Orion-Black/Orion-IoT_Board/docs/Schematic_IoT_Orion.pdf

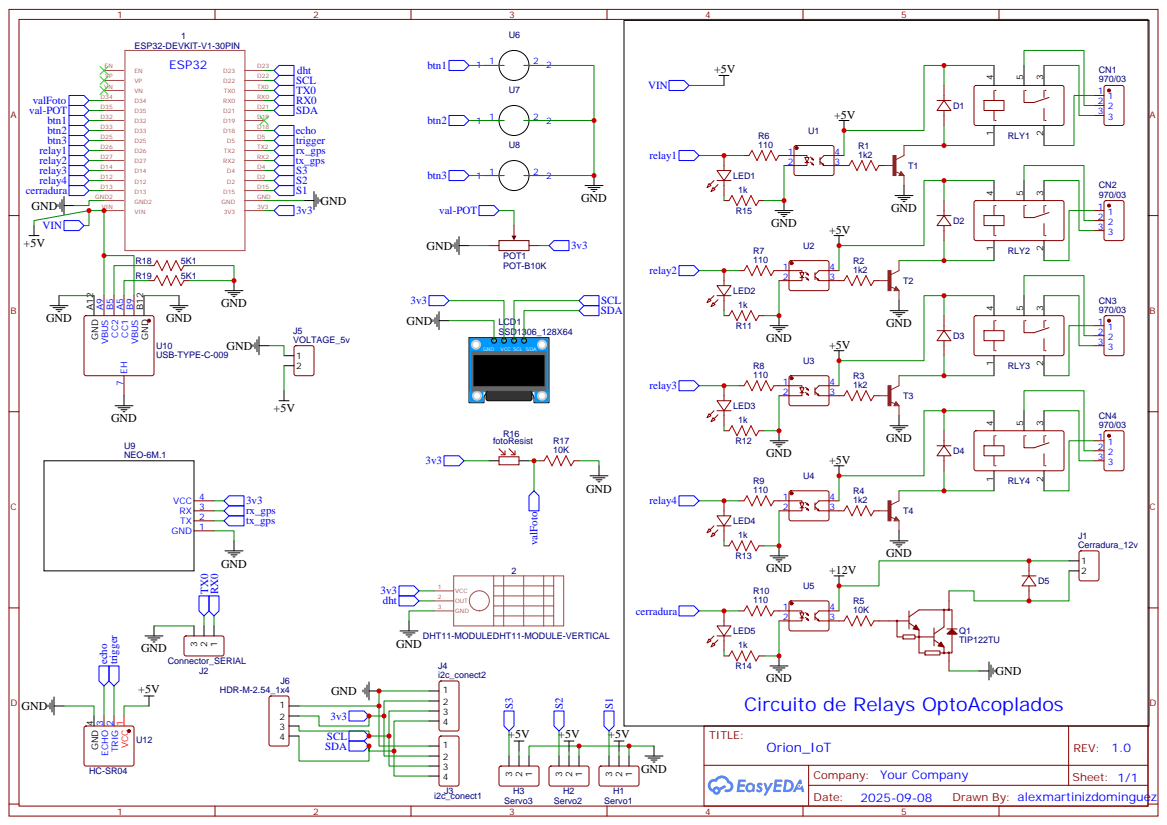
[picture p10: page 1]

GND VCC SCL SDA
