Orion-Black/Orion-IoT_Board/src/wifi_defaults.h

#ifndef WIFI_DEFAULTS_H
#define WIFI_DEFAULTS_H

#define DEFAULT_SSID "Starlink 2.4"
#define DEFAULT_PASS "L3tr4s_123"

#endif
