Orion-Black/Orion-IoT_Board/src/icons.h

// Logo principal Orion IoT
const unsigned char init_icon [] PROGMEM = {
	0x00, 0x00, 0x00, 0x00, 0x00, 0x00, 0x00, 0x00, 0x00, 0x00, 0x00, 0x00, 0x00, 0x00, 0x00, 0x00, 
	0x00, 0x00, 0x00, 0x01, 0xc0, 0x1c, 0x3c, 0x38, 0x03, 0x80, 0x00, 0x00, 0x00, 0x00, 0x00, 0x00, 
	0x00, 0x00, 0x01, 0xc0, 0x1e, 0x3c, 0x78, 0x03, 0xc0, 0x00, 0x00, 0x00, 0x00, 0x00, 0x00, 0x00, 
	0x00, 0x01, 0xc0, 0x1e, 0x3c, 0x78, 0x03, 0xc0, 0x00, 0x00, 0x00, 0x00, 0x00, 0x00, 0x00, 0x00, 
	0x01, 0xc0, 0x1e, 0x3c, 0x78, 0x03, 0xc0, 0x00, 0x00, 0x00, 0x00, 0x00, 0x00, 0x00, 0x30, 0x01, 
	0xc0, 0x1e, 0x3c, 0x78, 0x03, 0xc0, 0x06, 0x00, 0x00, 0x00, 0x00, 0x00, 0x00, 0xfc, 0x01, 0xce, 
	0x1e, 0x3c, 0x78, 0x73, 0xc0, 0x1f, 0x80, 0x00, 0x00, 0x00, 0x00, 0x01, 0xe6, 0x03, 0xcf, 0x1e, 
	0x3c, 0x78, 0xf3, 0xc0, 0x23, 0x80, 0x00, 0x00, 0x00, 0x00, 0x00, 0xe4, 0x0f, 0xce, 0x0c, 0x18, 
	0x30, 0x63, 0xf0, 0x23, 0x80, 0x00, 0x00, 0x00, 0x00, 0x00, 0x78, 0x3f, 0x00, 0x00, 0x00, 0x00, 
	0x00, 0xfc, 0x0f, 0x00, 0x00, 0x00, 0x00, 0x00, 0x00, 0x00, 0x7c, 0x00, 0x00, 0x00, 0x00, 0x00, 
	0x1f, 0x00, 0x00, 0x00, 0x00, 0x00, 0x00, 0x00, 0x01, 0xf0, 0x7f, 0xff, 0xff, 0xff, 0xff, 0x07, 
	0x80, 0x00, 0x00, 0x00, 0x00, 0x00, 0x00, 0x03, 0xc1, 0xff, 0xff, 0xff, 0xff, 0xff, 0xc3, 0xe0, 
	0x00, 0x00, 0x00, 0x00, 0x00, 0x1e, 0x07, 0x87, 0xe0, 0x00, 0x00, 0x00, 0x07, 0xf0, 0xf0, 0x38, 
	0x00, 0x00, 0x00, 0x00, 0x0f, 0x8f, 0x0f, 0x80, 0x00, 0x00, 0x00, 0x00, 0xf8, 0x70, 0xf8, 0x00, 
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
	0x00, 0x00, 0x0f, 0x1f, 0xf8, 0x00, 0x00, 0x00, 0x00, 0x00, 0x00, 0x78, 0x00, 0x00, 0x00, 0x00, 
	0x00, 0x0f, 0x00, 0x00, 0x00, 0x00, 0x00, 0x00, 0x00, 0x00, 0x3c, 0x00, 0x00, 0x00, 0x00, 0x00, 
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
};
