Orion-Black/Orion-IoT_Board/(commit log)

2026-01-09 Create Readme.md for Orion IoT Board Firmware
    Add detailed documentation for Orion IoT Board firmware, including features, hardware pinout, required libraries, and configuration instructions.
2026-01-09 Enhance README with PCB images
    Added images of PCB without and with components to the README.
2026-01-10 add Gerber file and icon for open hardware
2026-01-10 Enhance Readme with UI and operation details
    Added detailed user interface and operation stages for Orion IoT system, including images and descriptions of various modes and features.
2026-01-10 Revise Readme.md for Orion IoT Board Firmware
    Updated the Readme.md to include project details, usage instructions, and integration information.
