Orion-Black/Orion-IoT_Board/(notices)

Notices in the files:
Readme.md:
License: MIT
